joapolarbear/MIPS-CPU--5-segment-pipeline/verilog code/cpu-run1.0/Readme.txt

asm后缀文件为汇编源代码
hex后缀文件为汇编代码输出格式，课加载到logisim中的rom或ram
从mars导出的内存文件必须在第一行加上一个 v2.0 raw才能导入使用，如下例子

v2.0 raw
00008020
2011001c
8e130000
8e340000
0274402a
11000002
ae330000
ae140000
2231fffc
1611fff8
22100004
2011001c
1611fff5
2002000a
0000000c
