joapolarbear/MIPS-CPU--5-segment-pipeline/verilog code/cpu-run1.0/cpu2.runs/impl_1/.vivado.begin.rst

<?xml version="1.0"?>
<ProcessHandle Version="1" Minor="0">
    <Process Command="vivado.bat" Owner="Administrator" Host="WIN7-20140914MO" Pid="9096">
    </Process>
</ProcessHandle>
