joapolarbear/MIPS-CPU--5-segment-pipeline/zuyuan/组原资料包/3-5段流水线CPU设计V3.0（2017-02-27) .pptx

谭志虎 2017-02

五段流水CPU设计

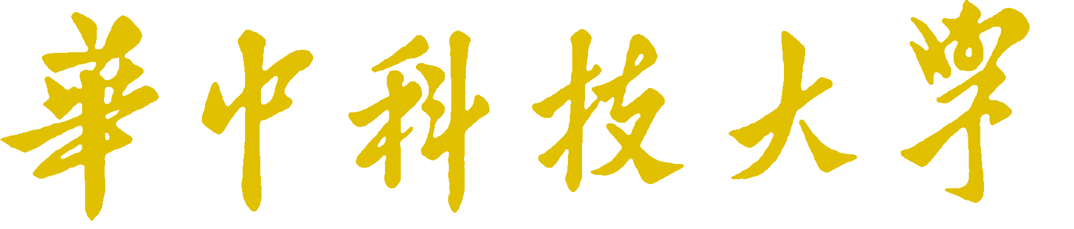
[picture p44: figure]

## 准备工作

- 按班级顺序从前到后分区就坐！
  - 各班自由组队（选4-5个种子秘密选秀）
  - 尽快上报小组名称
- 课设资料下载
  - 链接: https://pan.baidu.com/s/1b9JH98 密码: gsjq
- 注册tower论坛账号进行互动交流
  - http://tower.im
  - 昵称命名格式： 1306吴晨
  - 教师授权后即可看到相关版面

## 微助教平台

- 公众号：微助教 课堂编号：B715
  - 1、关注“微助教”公众号
  - 2、根据系统回复注册个人真实信息
  - 3、点击“学生”分组下“加入课堂”
  - 4、输入课堂编号即可加入
- 微助教主要用于请假签到，进度调查

## 指导检查教师

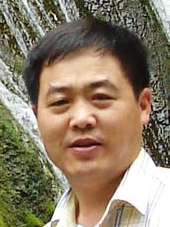
[picture p45: figure]

秦磊华

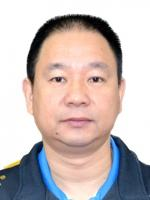
[picture p46: figure]

胡迪青

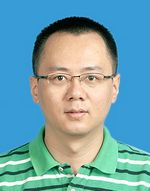
[picture p47: figure]

谭志虎

指导检查教师
5 班：谭志虎 6班：胡迪青 ACM班：秦磊华
卓越：谭志虎 物联网：胡迪青

## 纪律要求

- 严格考勤 周一~周五 8:00-11:00 14:00-17:00
  - 迟到，早退按缺勤处理
  - 9天18次考勤14次为满分
  - 报告完成后，可不考勤
  - 不来的要通过微助教签名请假
  - 代签到（作弊处理，直接-10分）
- 每日提交工作进度（一起写）
  - 每日24:00之前提交当日进度，未提交按缺勤处理
  - 边实验，边写报告
    - 在课设报告中记录当日故障，解决方法

## 成绩评定

- 成绩构成
  - 设计过程和结果占70%
  - 报告部分占 30%；
  - 缺勤直接负分（10%），
    - 缺勤4次，不扣分
    - 5次扣8分，6次扣10分，代签扣10分，不来微助教签到请假
    - 7次以上按缺勤1/3记，无最终成绩。
  - 抄袭或被抄袭 0分，报告查重
    - 单周期FPGA版本代码可以共享
    - 流水阶段代码不得共享
缺勤1/3记，无最终成绩。

## 进度安排

- 课程设计的总体时间为2周，具体安排如下:
  - 第1天：到实验室布置任务和集中讲解；
  - 第1~3天：学生查阅资料，开始方案设计；
  - 第4天：中期进度检查，单周期验收检查；
  - 阶段性成果随时检查；
  - 第10天：最终结果验收。
- 报告不得超过66页，第7周周一交报告
- 按班为单位提交电子版即可，具体规范见任务书

## 课程设计团队天梯赛

- 每班4-5只队伍，各班前两名团队有分数奖励（2/1分）
  - 组原不及格的队员成绩不计入团队总成绩
  - 重修生/留级生不计入团队总成绩
- 共同学习，互帮互助，团队精神
  - 每日上午8:00-8:30团队会议，轮值主席，轮值记录
  - 团队内有抄袭者团队全体罚分（5分）
  - 各团队自选团队杰出贡献奖2人（加2/1分奖励）
  - 会议记录不完整团队取消团队贡献奖和天梯赛奖励
- 奖励分数加到总分中，加爆为止

## 课程设计任务

- 利用FPGA开发板设计5段流水CPU
  - 支持27+4条教师指定的MIPS指令（每人一个4位代号CCMB）
  - 支持中断处理机制
  - 支持5段流水机制，可处理数据冒险，结构冒险，分支冒险
  - 扩展功能（流水中断，动态分支预测）
  - 能正确运行标准测试程序和自编测试程序（测试CCMB指令）
  - 具有自动统计功能
    - 运行周期数
    - 插入气泡数 ，Load Use冲突次数
    - 无条件跳转次数，有条件成功跳转次数，失败跳转次数
    - 分支预测成功，失败次数等（分支预测相关）

## 课程设计实验环境

- LOGISIM
  - 先Logisim进行方案论证
  - 跑通流水线重定向机制
- FPGA开发板
  - 单周期上板（合作开发）
  - 流水线上板（独立开发）
  - 完成时序仿真后再开始领板子

## 物联网，卓越班课程设计路径及评分标准

单周期 FPGA　30分

将课程实验工作移植FPGA
小组充分分工合作，代码共享
FPGA平台

扩充指令　35分

支持4条CCMB指令
编写有展示度的测试程序
Logisim、FPGA都要检查

中断支持 42（嵌套+4）

设计中断相关硬件
设计中断演示程序（及格了）
Logisim平台

理想流水线 47

设计流水段间接口部件
好矬，只能跑几条指令）
Logisim平台

顺利通关（爽）
最高73分

重定向流水线 54

重定向机制设计，Logisim平台
控制器改造（自信心爆棚）

气泡流水线 50

数据冲突检测，处理分支冲突
插入气泡解决数据冲突（跑起来了耶）
Logisim平台

FPGA流水线 60

上板调试（告别LOGISIM）
抓狂，抓狂，抓狂

扩展： 中断流水线 +6

流水线中断机制实现
（是不是有点小牛叉）FPGA

扩展：分支预测 +10

分支预测机制 FPGA
大boss来了！！！

## 1401-1410课程设计路径及评分标准

扩充指令　35

支持所有指令（开工）
编写有展示度的测试程序

中断支持 40 嵌套+4

设计中断相关硬件(单级/嵌套)
设计中断演示程序（及格了）

理想流水线 45

设计流水段间接口部件
（好矬，只能跑几条指令）

气泡流水线 48

数据冲突检测，处理分支冲突
插入气泡解决数据冲突（跑起来了耶）

FPGA流水线 60

上板调试（告别LOGISIM）
抓狂，抓狂，抓狂

重定向流水线 52

重定向机制设计
控制器改造（自信心爆棚）

扩展： 中断流水线 +6

流水线中断机制实现
（是不是有点小牛叉）

扩展：分支预测 +10

分支预测机制
大boss来了！！！

顺利通关（爽）
最高73分

## 我们的口号

奋战一两周，造块ＣＰＵ

调试两三晚，玩转开发板

虐我千百遍，搞定流水线

## 各阶段检查要求

- 单周期CPU检查
  - 能运行benchmark程序，周期数1546，内存数据排序正确
  - 单周期CPU能运行自己的CCMB程序
    - 编写一段能在数码管上展示指令功能的程序
  - FPGA开发板应绑定功能开关
    - 可切换显示区域功能
    - 程序显示，时钟周期统计，内存数据观察
- 中断检查
  - 主程序benchmark
  - 单级中断依次点击1,2,3号中断源按键，能正常响应中断
  - 多重嵌套中断依次点击1,3,2号中断源按键
    - 应先后进入1→3→2→1→CPU

## 各阶段检查要求

- 理想流水线
  - 能运行理想流水线测试程序
  - 周期数21，内存数据写入正常
- 气泡流水线
  - 能正确运行benchmark程序
  - 能统计气泡数目，分支跳转次数
  - 总周期数=1546+4+气泡数目+分支误取深度*分支数-1
- 重定向流水线
  - 能正确运行benchmark程序
  - 能统计Load-Use次数，分支数
  - 总周期数=1546+4+分支误取深度*分支数+load-Use次数
  - 参考答案（1984，2298，3612），其他答案说明理由

## 注意事项

- 多讨论，多讨论，多讨论
  - 没有愚蠢的问题，不要闭门造车
  - 方案不是唯一的，但一定要想清楚！
- 多存盘，存网盘，别存U盘
  - 注意版本管理
- 要通关，要通关，要通关
- 没有哪一本书能讲清楚所有内容，多阅读文献。
- 教材很多坑，不要尽信书，弄清原理自己干

## 注意事项

- 可以使用任何logisim内建的电路组件
- 控制器电路必须用逻辑表达式生成，每个信号均应有逻辑表达式，便于书写报告，避免使用比较器。
- 指令ROM和数据RAM必须在main电路中可见，不能封装在子电路中。
- 显示模块应该在主电路中可见。
- 主要部件之间还是需要适当连线，隧道工具不能滥用，要能看清楚各部件之间的连接关系。

## 注意事项

- 尽可能使用标签工具注释电路，包括控制信号，数据通路，显示模块，总线等，会使得电路更加容易调试！
- 注意标签以及注释的命名规范，过长的命名会对后续的画图连接造成影响。
- Logisim中可以将不同的模块用不同的颜色区分，建议用颜色区分各接口部件和关键模块。
- 接口部件封装尽可能封装的长一点，否则控制线多了以后不方便布线。
- 控制器建议用表达式自动生成，比手工画要简单
- 断点调试功能非常有用，建议单周期调试一定要加。

## 注意事项

- PC，IR最好一直传递到最后一级，这样方便观测流水线运行的状况。
- 流水线各级是否产生气泡可以用LED指示灯显示，方便观察流水线运行状况。
- 各里程碑版本经过充分测试后，备份后再开新的分支进行新的开发，以避免新版本无法开发成功，老版本又检查不了的悲剧。

## Slide 20

中断机制运行原理

## 中断实现规范

- 3个按键中断源，分别对应3个中断服务程序
  - 具体程序使用测试用例中的中断演示程序
- 优先级3>2>1>0(CPU)
- 单级中断（多中断源）
  - 不同按键可以触发不同的中断服务程序
  - 如正在执行中断，不能其他中断请求再次中断
  - 中断过程中能缓存新的中断请求
- 多重嵌套中断（多中断源）
  - 不同按键可以触发不同的中断服务程序
  - 如正在执行中断，高优先级中断可打断当前中断服务
  - 中断过程中能缓存新的中断请求

## 中断电路检查规范

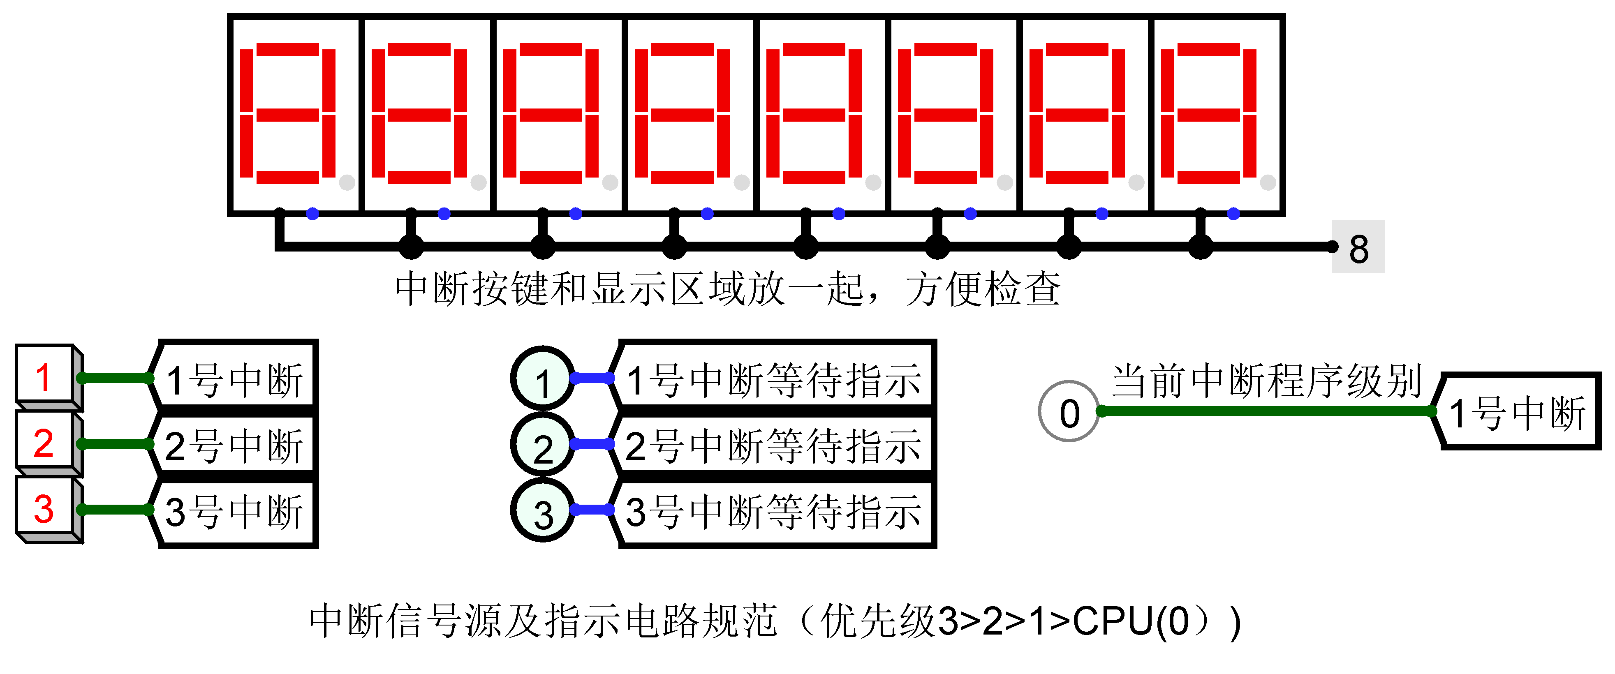
[picture p48: figure]

## 中断请求信号生成电路参考

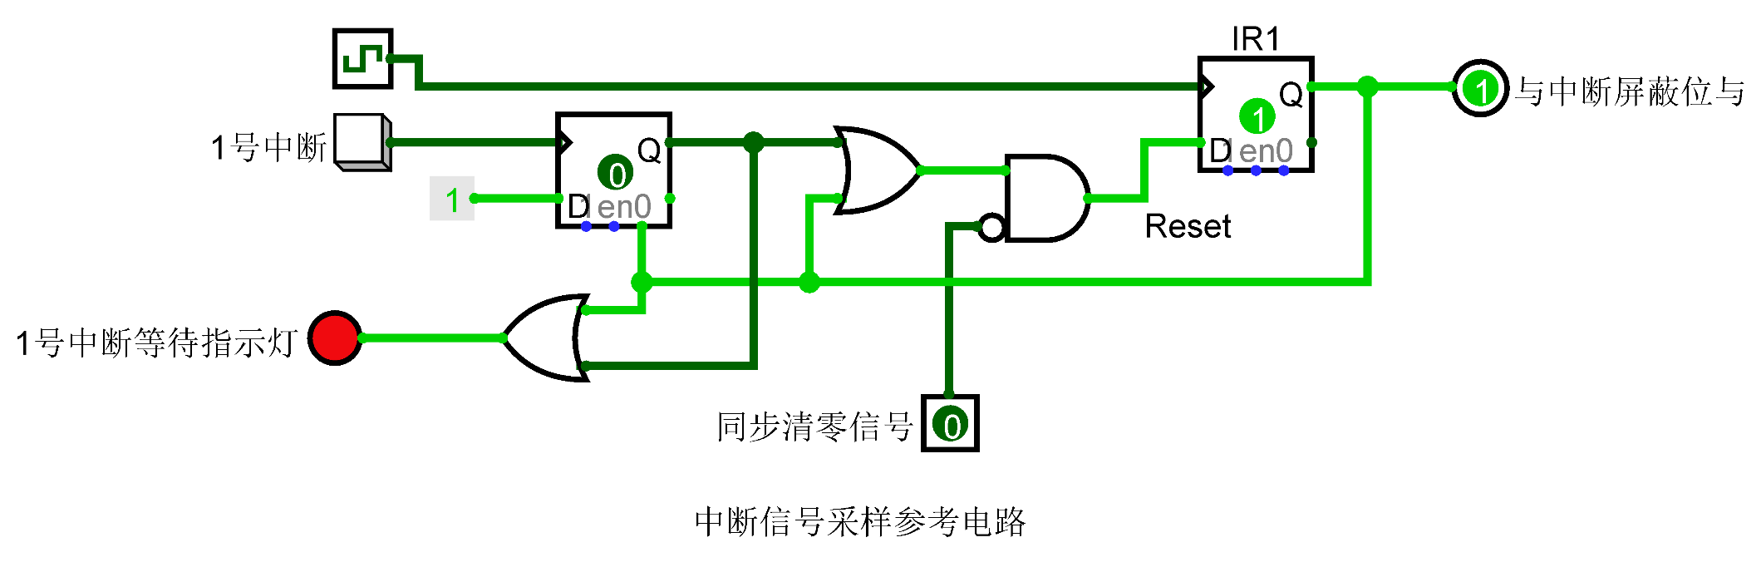
[picture p49: figure]

## 中断机制18问

1. 函数调用JAL与中断有多大区别，有否共同之处？
2. 不同的中断请求存储在哪里，何时消失？
3. 硬件响应优先级用什么电路实现，为什么要有处理优先级。
4. 中断屏蔽寄存器有什么作用，何时设置中断屏蔽字，真实计算机环境中由什么程序设置中断屏蔽字？本实验是否需要中断屏蔽寄存器？
5. 中断使能寄存器是干什么用的？
6. CPU如何判断当前有中断需要响应？

## 中断机制18问

7. CPU发现当前存在中断事件后要做什么动作，什么时候响应中断事件？哪些是硬件完成，哪些是软件完成？由硬件完成的动作需要多少个时钟周期，此时CPU能否执行指令？
8. 单级中断断点保存在哪里，多级嵌套中断的断点如何处理？
9. 中断处理程序中的现场有哪些，我们实验中需要考虑保存哪些现场？
10. 中断程序入口地址如何识别？硬件还是软件完成？哪种方案比较好，为什么？
11. 开中断，关中断在MIPS指令集中如何实现？

## 中断机制18问

12. 中断使能寄存器IE有什么作用，在MIPS CPU中如何实现？
13. 中断处理程序放在指令存储器中的那个位置，如何载入到ROM中？
14. 数据堆栈放在哪里？SP寄存器如何设置？MIPS如何访问堆栈？
15. 按键中断是电平触发还是跳变触发？连续按键如何处理？实际系统中是如何处理的？
16. 高优先级中断服务程序执行过程中，有新的按键事件发生，如何处理？
17. 实验中的中断机制为啥要用CP0，不要是否可以？在我们的实验中如何简化？
18. 开中断和eret指令是否有先后顺序，如果先开中断，再eret会有什么问题？

## 中断仲裁电路（单级中断无INM）

响
应
优
先
级

## Slide 28

取指令

取指令

单重中断

No

执行指令

中断

执行指令

中断

No

多重中断

Yes

Yes

中断隐指令

中断
周期

中断
服务程序

关中断

中断
周期

中断
服务程序

关中断

保存断点---PC压栈

保存断点---PC压栈

中断识别，地址→PC

中断识别，地址→PC

保护现场

保护现场（含屏蔽字）
设置新的屏蔽字

恢复现场

设备中断服务子程序

设备中断服务子程序

开中断

开中断

关中断，恢复现场，开中断

中断返回 断点→PC

中断返回 断点→PC

## Slide 29

流水运行机制

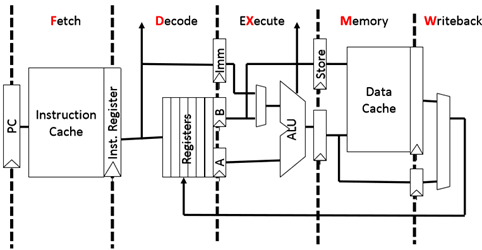
[picture p50: figure]

## 流水线原理

- 1.时间并行
  - 把任务分成若干子任务，使子任务在流水线的各阶段并发地执行
- 2.空间并行
  - 资源重复 多处理器系统和多计算机系统
- 3.时间并行+空间并行
  - 时间重叠和资源重复的综合应用。
  - 奔腾CPU采用超标量流水技术，一个机器周期执行两条指令。

## 指令周期细分

1. 取指令 IF (Instruction Fetch)
2. 指令译码 ID (Instruction Decode)
3. 执行运算 EX (Execution)
4. 访存阶段 MEM
5. 结果写回 WB (Write Back)
一条指令不一定经历所有阶段

IF

ID

EX

MEM

WB

## 非流水线时空图

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
## 流水线时空图

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
## 为何要使用流水线技术

- 单周期CPI=1
- T=IF+ID+EX+MEM+WB
- 慢
- 流水线理想性能T/5，
- 流水线充满后每隔一个T/5，完成一条指令

## 理想流水线

- 所有对象均通过同样的部件（阶段）
- 不同阶段之间无共享资源
- 各段传输延迟一致（取最慢的同步）
- 进入流水线的对象不受其他阶段的影响
- 适合工业流水线
- 绿色部件为各段间接口，各段间通过接口传递什么？
  - 待加工的数据、控制数据加工的控制信号、反馈信号
  - 否则后段无法对数据 进行处理

IF

ID

EX

MEM

WB

CLK

## Slide 36

- 现实是残酷的
- 指令不适合流水

## 指令流水线？

- 资源相关
  - 取操作数与取指令都需要访问主存，
- 数据相关
  - 后一条指令的操作数依赖于前一条指令的执行结果
- 分支相关
  - 转移指令使得流水线发生中断

## 单周期MIPS处理器改流水线

## 单周期改五段流水（分段）

- 分段原则

IF 取指令

ID 译码

EX 执行

Mem 访存

WB 写回

## 消除结构相关的理想流水线

- 消除通路中结构相关
  - 指令数据存储器分离
- 将指令过程分成5个阶段 （所有指令至少3个阶段）
  - IF ID EX MEM WB
- 不同阶段之间设置缓冲接口部件
  - 构建各阶段之间的接口部件（本质是寄存器）
  - 流水线通过接口传递与指令相关的数据信息，控制信息，反馈信息
  - 后续部件对数据的加工处理依赖于前阶段传递过来的信息
- ID段译码生成该指令的所有控制信号
  - 控制信号向后传递
  - 后续部件控制信号不再单独生成
  - 单周期CPU实现中的控制器在ID段复用

## 5段流水控制信号传递

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
IF 取指令

ID 译码

EX 执行

Mem 访存

WB 写回

## 接口定义（仅供参考）

- IF→IF/ID
  - 数据 IR
- ID→ID/EX
  - 数据 IR WriteReg# A B
  - 控制 ALU OP、IMM、ALUSrc、 beq，bne，jmp
  - MemReq MemWrite RegWrite MemRead
- EX→EX/MEM
  - 数据 IR WriteReg# AluResult Rt
  - 控制 MemReq MemWrite RegWrite MemRead
- MEM→MEM/WB
  - 数据 WriteReg# WriteBackData
  - 控制 RegWrite
- PC IR请全部传递，便于流水线调试

## 数据相关

add $0,$1,$2

or $1,$1,$2

and $1,$1,$2

lw $1,$2,4

$0=$1+$2

$1=$1 | $2

$1=$1&$2

$1=Mem[$2+4]

## 相关检测

- ID段进行检测
- 不同类型指令有区分
  - R型指令
    - 涉及两个源操作数Rs,Rt
  - I型指令
    - 涉及一个或两个源操作数Rs（Lui无相关）
  - 其他分支指令（Beq，Bne, Bgt）
    - 涉及两个源操作数Rs,Rt
  - J型指令（无相关,直接产生分支相关信号）
  - 相关数据需与后续段中的结果寄存器编号比较
    - EX.WriteReg Mem.WriteReg WB.WriteReg ？？？
    - 写回信号

## 数据相关

- 软件方法
  - 插入空指令
  - 调整程序顺序，是相关性在流水线中消失
  - 编译器完成
- 硬件方法
  - 寄存器堆写入和读出过程分离（先写后读，下跳沿写）
  - 插入气泡
    - 向流水线后段插入气泡
    - 向前给出流水线阻塞信号
    - 避免当前指令被新指令取代
  - 数据重定向bypass
    - 将后端处理后的数据（还没来得及写回）重定向

## 理想流水线

- 所有对象均通过同样的部件（阶段）
- 不同阶段之间无共享资源
- 各段传输延迟一致（取最慢的同步）
- 进入流水线的对象不受其他阶段的影响
- 适合工业流水线

## 理想指令流水线

IF

ID

EX

MEM

WB

CLK

- 将指令过程分成5个阶段 （所有指令至少3个阶段）
  - IF、ID、EX、MEM、WB
- 不同阶段之间设置缓冲接口部件（绿色部分）
  - 接口部件本质是寄存器
  - 各段通过接口传递与指令相关的数据，控制，反馈信息
  - 对数据的加工处理依赖于前段接口传递过来的信息
- 冒险(相关)给流水线带来诸多实际实现问题

## 单周期改五段流水（分段）

- 分段原则
  - 各段时间均等
  - 流水线深度？

IF 取指令

ID 译码

EX 执行

Mem 访存

WB 写回

消除通路中资源相关
指令数据存储器分离
读写寄存器如何处理？

## 5段流水控制数据与信号传递

ID段译码生成该指令的所有控制信号
控制信号向后传递，后续部件控制信号不再单独生成

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
IF 取指令

ID 译码

IMM

EX 执行

Mem 访存

WB 写回

## 流水线的相关冲突（hazzard）

- 资源相关
  - 取操作数与取指令都需要访问主存
  - 多周期方案中计算PC、分支地址，运算指令 复用ALU
  - 增加部件消除
- 数据相关
  - 指令操作数依赖于前一条指令的执行结果
  - 引起流水线停顿直到数据写回
- 分支相关
  - 转移指令使得流水线发生中断
  - 提前取出指令作废，流水线清空

## 数据相关

add $0,$1,$2

or $1,$1,$2

and $1,$1,$2

lw $1,$2,4

ID段取操作数

$0=$1+$2

$1=$1 | $2

$1=$1&$2

$1=Mem[$2+4]

- ID段所需数据可能还未及时写回，涉及前续3条指令

## 数据相关处理

- 增加相关检测判定逻辑
  - 当前指令读寄存器编号与后续3条指令写寄存器编号相同
  - 当前指令可能有0~2个读寄存器
  - 后续3条指令可能有0~1个写寄存器
- 相关处理逻辑
  - 流水线停顿
  - 数据重定向

## 相关检测

- ID段进行检测
- 不同类型指令有区分
  - R型指令
    - 涉及两个源操作数Rs,Rt
  - I型指令
    - 涉及一个或两个源操作数Rs,Rt
  - 其他分支指令（Beq，Bne）
    - 涉及两个源操作数Rs,Rt
  - J型指令（无相关,直接产生分支相关信号）
  - 相关数据需与后续段中的结果寄存器编号比较
    - EX.WriteReg Mem.WriteReg WB.WriteReg
    - 写回信号

## 数据相关处理机制

- 软件方法（编译器完成）
  - 插入空指令
  - 调整程序顺序，使相关性在流水线中消失
- 硬件方法
  - 寄存器堆写入和读出过程分离（先写后读，下跳沿写）
  - 插入气泡（空操作）
    - 向后段插入气泡（接口信号清零，最关键的是写回信号）
    - 向前给出阻塞信号（流水线停顿）避免当前指令被新指令取代
  - 数据重定向bypass（数据旁路）
    - 将后端处理后的数据（还没来得及写回）重定向
    - 数据在哪就从哪送到运算器

## 插入气泡

add $0,$1,$2

or $1,$1,$2

and $3,$1,$2

$0=$1+$2

$1=$1 | $2

$3=$1&$2

## 插入气泡

add $0,$1,$2

前段停顿

nop

or $1,$1,$2

and $3,$1,$2

等待数据

后段插气泡

$0=$1+$2

气泡

$1=$1 | $2

$3=$1&$2

## 插入气泡

add $0,$1,$2

nop

nop

or $1,$1,$2

$0=$1+$2

nop

nop

$1=$1 | $2

## 插入气泡

add $0,$1,$2

nop

nop

nop

$0=$1+$2

nop

nop

nop

## 插入气泡

New inctruction

add $0,$1,$2

nop

nop

$0=$1+$2

nop

nop

## 气泡处理流程

IF | ID | EX | M | WB

1

2 | 1

3 | 2 | 1

4 | 3 | 2 | 1

指令4与3数据相关

指令4 ID段不能取到正确数据

5 | 4 | 3 | 2 | 1

5 | 4 | 气泡 | 3 | 2

相关插入气泡，前段暂停

5 | 4 | 气泡 | 气泡 | 3

5 | 4 | 气泡 | 气泡 | 气泡

仍然相关，继续插入气泡

仍然相关，继续插入气泡

6 j | 5 | 4 | 气泡 | 气泡

相关解除，流水线继续

7 | 6 j | 5 | 4 | 气泡

8 | 7 | 6j | 5 | 4

指令6为跳转指令

15 | 气泡 | 气泡 | 6j | 5

清空误取的指令，同步/异步清空？

16 | 15 | 气泡 | 气泡 | 6 j

## 分支相关

sub $0,$1,$2

Add $0,$1,$2

无用指令

Jmp 0001

无用指令

$0=$1+$2

0001→PC

## 分支相关

正确指令

nop

nop

Jmp 0001

0001→PC

## 插入气泡总结

- 气泡=空操作
- 数据相关时需插入气泡
  - 向后段插入一个气泡（接口信号清零，最关键的是写回信号）
  - 向前给出阻塞信号（流水线停顿）避免当前指令被新指令
- 分支相关时
  - 向前段发出清零信号，清除误取的指令
  - 后续指令继续执行
- 气泡过多，效率较低
- 进一步优化
  - 寄存器堆写入和读出过程分离（先写后读，下跳沿写）
  - 数据重定向（forwarding、bypass）

## 数据重定向

or $1,$1,$2

and $1,$3,$4

lw $2,$3,4

$1=$3&$4

$1=$1 | $2

$2=Mem[$3+4]

## Load Use相关（不能重定向）

执行段路径时间过长=访存时间+ALU时间
正确方法：ID段发现Load-Use相关，插入一个气泡

or $1,$1,$2

Lw $1,$2,4

$1=$1 | $2

$1=Mem[$2+4]

## Load Use相关

ID段发现Load-Use相关，插入一个气泡

or $1,$1,$2

Lw $1,$2,4

$1=$1 | $2

$1=Mem[$2+4]

## Load Use相关

ID段发现Load-Use相关，插入一个气泡

or $1,$1,$2

Nop（气泡）

Lw $1,$2,4

$1=$1 | $2

Nop（气泡）

$1=Mem[$2+4]

## 全冒险处理机制的流水CPU

分支指令在哪个阶段完成？ Why？

## LOGISIM流水示意图

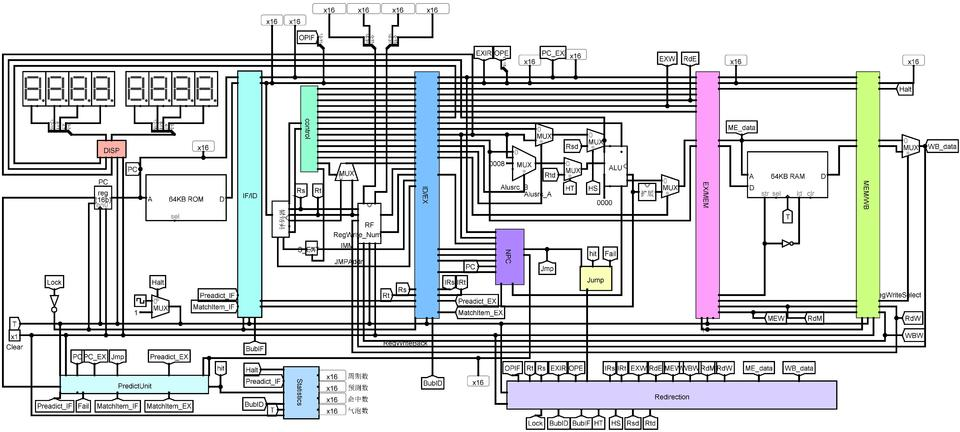
[picture p51: figure]

接口部件封装尽可能封装的长一点，分段清晰。
连接清晰，不滥用隧道
布局合理，适度封装

## 流水需要考虑的问题

- 流水分段原则（各段时间均衡，否则按慢速同步）
- 分支指令在那个阶段完成，为什么
  - 无误取的实现虽然在logsim中可实现，但实际不可行，why？
- 译码段与写回段之间的数据相关是否必须插入气泡？
- Syscall是否有数据相关，如何处理？
- Load Use冲突能否重定向解决,why?
- 流水线中断时中断哪条指令，如果有两条指令同时完成如何处理？

## 动态分支预测要求

- 实现BHT表（Branch History Table）
  - 8个表项，表项内容如下
    - Valid位，PC，BranchAddr，双预测位，LRU调度标记
- 预测思路
  - 以PC为关键字到BHT表做全相联比较查找，如果命中，直接根据预测位给出下一条指令正确地址（取指令阶段，与取指令并行）
  - 执行阶段遇到跳转指令
    - BHT命中，根据跳转情况更新预测位，LRU调度标记清零
    - BHT不命中，将对应指令信息放入BHT表
- 关键技术
  - 全相联存储器实现，LRU调度实现
  - 双位预测状态机实现
