joapolarbear/MIPS-CPU--5-segment-pipeline/(list of files, drawings)

Other design files:
zuyuan/1组原课设实现/7400-lib/7400-lib.circ
zuyuan/1组原课设实现/7400-series-rev1/7400-series-rev1.circ
zuyuan/1组原课设实现/ACM1401_U201414620_胡汉鹏_alu (2).circ
zuyuan/1组原课设实现/ACM1401_U201414620_胡汉鹏_alu.circ
zuyuan/1组原课设实现/ACM1401_U201414620_胡汉鹏_cpu.circ
zuyuan/1组原课设实现/ACM1401_U201414620_胡汉鹏_regfile.circ
zuyuan/1组原课设实现/alu-test.circ
zuyuan/1组原课设实现/cpu1.circ
zuyuan/1组原课设实现/cpu4.0.circ
zuyuan/1组原课设实现/cpu5.1.circ
zuyuan/1组原课设实现/cpu6.1.circ
zuyuan/1组原课设实现/cpu多保存几份.circ
zuyuan/1组原课设实现/logisim-常见故障.circ
zuyuan/1组原课设实现/logisim_74v1/7442.circ
zuyuan/1组原课设实现/logisim_74v1/7442v2.circ
zuyuan/1组原课设实现/logisim_74v1/7451.circ
zuyuan/1组原课设实现/logisim_74v1/7474.circ
zuyuan/1组原课设实现/logisim_74v1/7476.circ
zuyuan/1组原课设实现/logisim_74v1/74109.circ
zuyuan/1组原课设实现/logisim_74v1/74138.circ
zuyuan/1组原课设实现/logisim_74v1/74147.circ
zuyuan/1组原课设实现/logisim_74v1/74148.circ
zuyuan/1组原课设实现/logisim_74v1/74151.circ
zuyuan/1组原课设实现/logisim_74v1/74154.circ
zuyuan/1组原课设实现/logisim_74v1/74157.circ
zuyuan/1组原课设实现/logisim_74v1/74160.circ
zuyuan/1组原课设实现/logisim_74v1/74163.circ
zuyuan/1组原课设实现/logisim_74v1/74163v2.circ
zuyuan/1组原课设实现/logisim_74v1/74164.circ
zuyuan/1组原课设实现/logisim_74v1/74165.circ
zuyuan/1组原课设实现/logisim_74v1/74166.circ
zuyuan/1组原课设实现/logisim_74v1/74173.circ
zuyuan/1组原课设实现/logisim_74v1/74181 v3.circ
zuyuan/1组原课设实现/logisim_74v1/74182.circ
zuyuan/1组原课设实现/logisim_74v1/74193.circ
zuyuan/1组原课设实现/logisim_74v1/74273.circ
zuyuan/1组原课设实现/logisim_74v1/74374.circ
zuyuan/1组原课设实现/logisim_74v1/74385.circ
zuyuan/1组原课设实现/logisim_74v1/74670.circ
zuyuan/1组原课设实现/regfile-test.circ
zuyuan/1组原课设实现/备份文件/ACM1401_U201414620_胡汉鹏_alu.circ
zuyuan/1组原课设实现/备份文件/ACM1401_U201414620_胡汉鹏_regfile.circ
zuyuan/1组原课设实现/备份文件/cpu1.0.circ
zuyuan/1组原课设实现/备份文件/cpu1.1.circ
zuyuan/1组原课设实现/备份文件/cpu1.2.circ
zuyuan/1组原课设实现/备份文件/cpu1.3.circ
zuyuan/1组原课设实现/备份文件/cpu1.4中断检查完成.circ
zuyuan/1组原课设实现/备份文件/cpu2.1.circ
zuyuan/1组原课设实现/备份文件/cpu2.2.circ
zuyuan/1组原课设实现/备份文件/cpu3.1.circ
zuyuan/1组原课设实现/备份文件/cpu3.2.circ
zuyuan/1组原课设实现/备份文件/cpu3.3.circ
zuyuan/1组原课设实现/备份文件/cpu4.0.circ
zuyuan/1组原课设实现/备份文件/cpu4.1.circ
zuyuan/1组原课设实现/备份文件/cpu4.2.circ
zuyuan/1组原课设实现/备份文件/cpu5.1.circ
zuyuan/1组原课设实现/备份文件/cpu5.2.circ
zuyuan/1组原课设实现/备份文件/cpu6.0.circ
zuyuan/1组原课设实现/备份文件/cpu6.1.circ
zuyuan/1组原课设实现/备份文件/cpu6.2.circ
zuyuan/2组原课设报告/logisim文件/ACM1401_U201414620_胡汉鹏_alu.circ
zuyuan/2组原课设报告/logisim文件/ACM1401_U201414620_胡汉鹏_regfile.circ
zuyuan/2组原课设报告/logisim文件/cpu1.4中断检查完成.circ
zuyuan/2组原课设报告/logisim文件/cpu2.2理想流水.circ
zuyuan/2组原课设报告/logisim文件/cpu3.3气泡流水.circ
zuyuan/2组原课设报告/logisim文件/cpu4.2重定向流水.circ
zuyuan/2组原课设报告/logisim文件/cpu5.2FPGA流水.circ
zuyuan/2组原课设报告/logisim文件/cpu6.2嵌套中断流水.circ
zuyuan/logisim其他版本/mipsalu.circ
zuyuan/组原资料包/中断按键信号产生.circ
