joapolarbear/MIPS-CPU--5-segment-pipeline/verilog code/cpu-run4.1-final/cpu2.srcs/sources_1/new/Equal.v

`timescale 1ns / 1ps
//////////////////////////////////////////////////////////////////////////////////
// Company: 
// Engineer: 
// 
// Create Date: 2017/03/04 15:48:34
// Design Name: 
// Module Name: Equal
// Project Name: 
// Target Devices: 
// Tool Versions: 
// Description: 
// 
// Dependencies: 
// 
// Revision:
// Revision 0.01 - File Created
// Additional Comments:
// 
//////////////////////////////////////////////////////////////////////////////////


module Equal(a, b, isequal );
    input [31:0] a, b;
    output reg isequal;
    
    always @(a, b) begin
        if(a == b)
            isequal = 1;
        else 
            isequal = 0;
    end
endmodule
