joapolarbear/MIPS-CPU--5-segment-pipeline/verilog code/cpu-run4.1-final/cpu2.srcs/sources_1/new/mux2_1width_16.v

`timescale 1ns / 1ps
//////////////////////////////////////////////////////////////////////////////////
// Company: 
// Engineer: 
// 
// Create Date: 2017/03/05 09:59:54
// Design Name: 
// Module Name: mux2_1width_16
// Project Name: 
// Target Devices: 
// Tool Versions: 
// Description: 
// 
// Dependencies: 
// 
// Revision:
// Revision 0.01 - File Created
// Additional Comments:
// 
//////////////////////////////////////////////////////////////////////////////////


module mux2_1width_16(sel, a, b,
    out
    );
    input sel;
    input [15:0] a, b;
    output reg[15:0] out;
    always @(sel , a, b)
        if(!sel)
            out = a;
        else
            out = b;
endmodule
